AlpenglowIndustries/Alpenglow-Swift/Swift Clamps/SwiftClamps.png

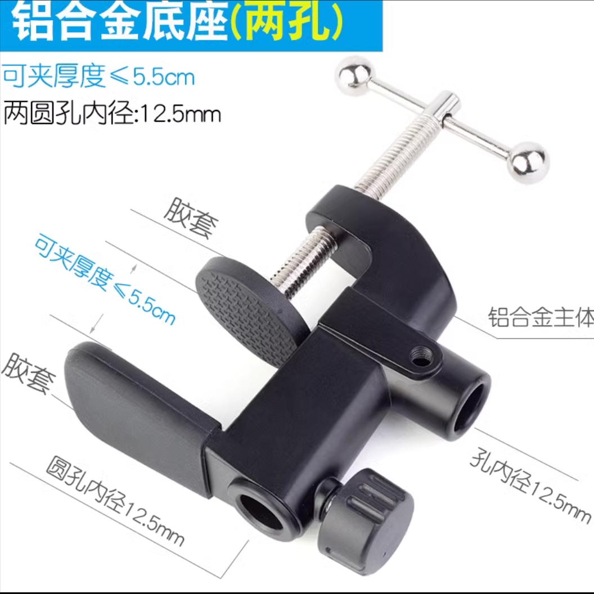
Swift Clamps/SwiftClamps.png
