AlpenglowIndustries/Alpenglow-Swift/Swift Struts/StrutShippingBoxConfig.png

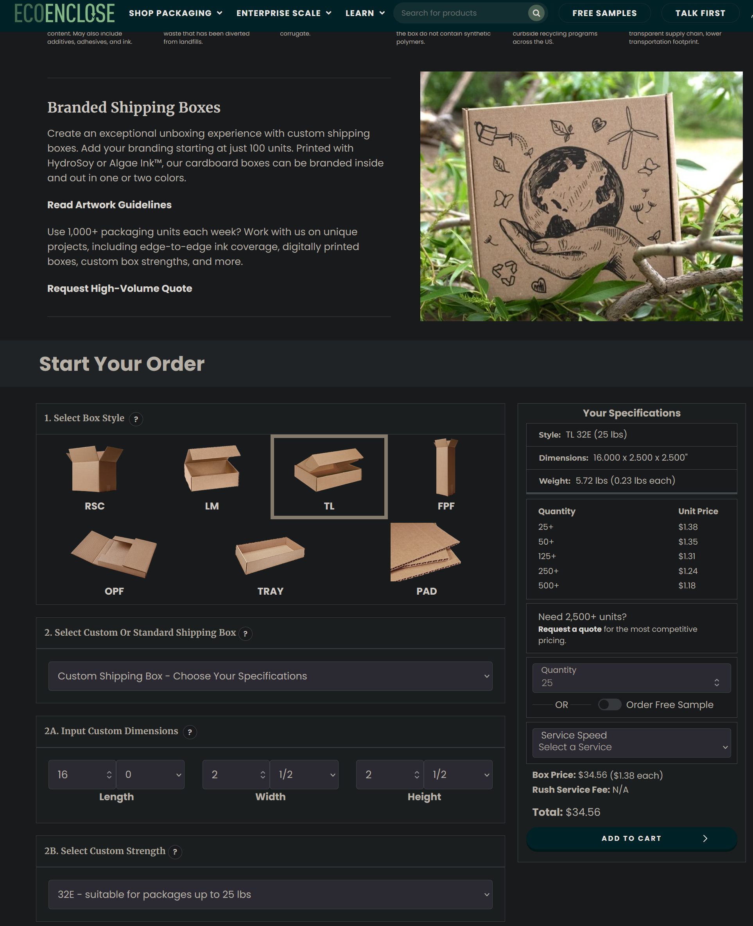
Swift Struts/StrutShippingBoxConfig.png
