AlpenglowIndustries/Alpenglow-Swift/Swift Misc/Strut Ties BUB-66-1.pdf

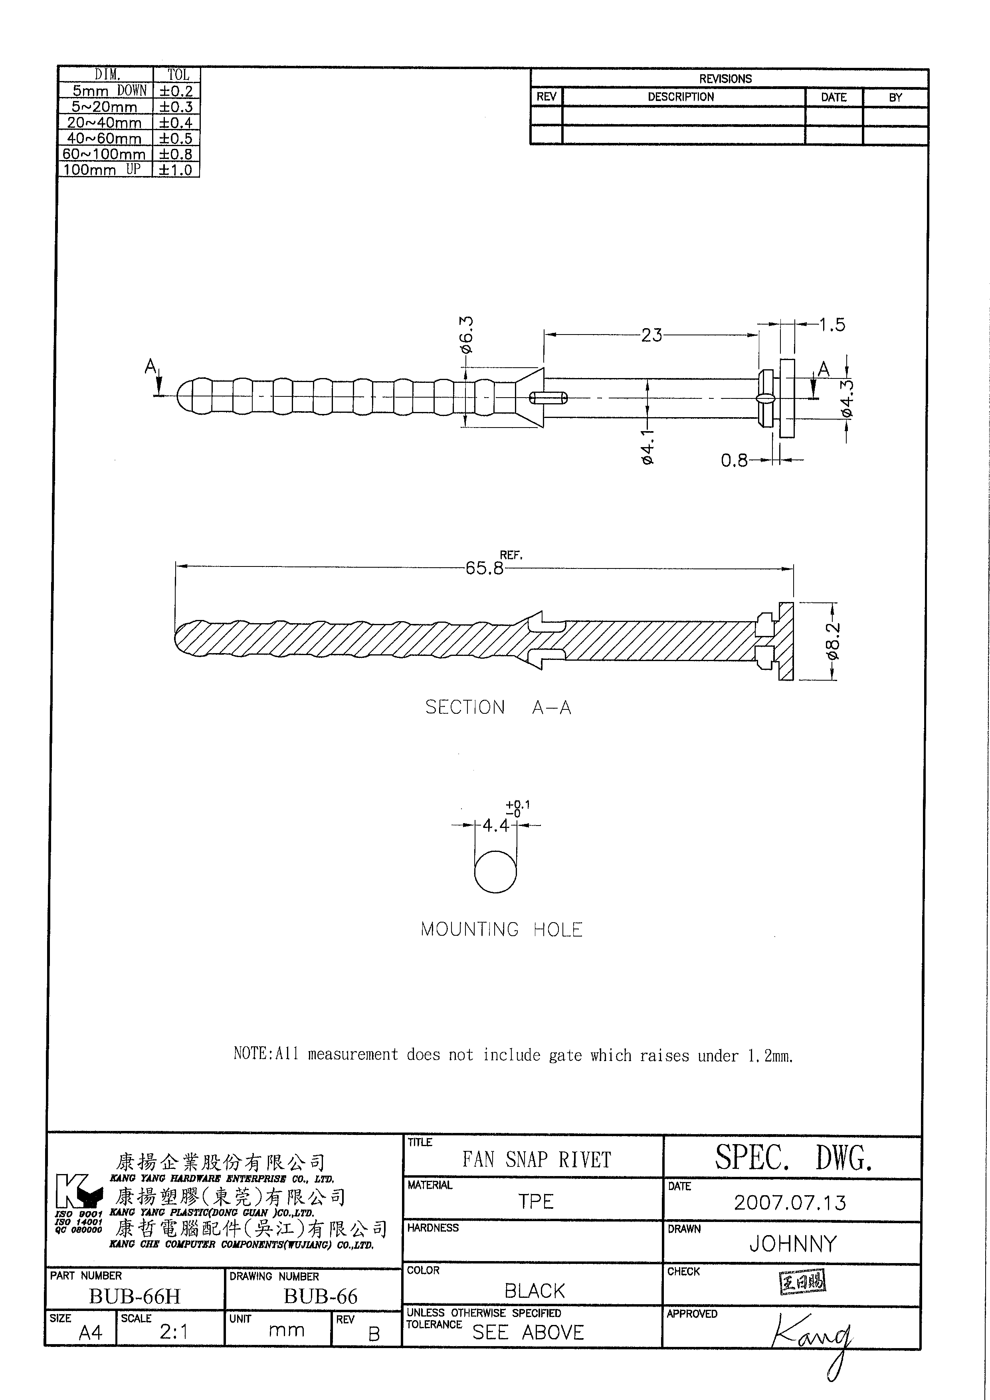
[picture p3: page 1]
