AlpenglowIndustries/Alpenglow-Swift/AlpenglowSwiftBOM.xlsx

Sheet: Swift BOM
Line |  | Type | Qty | Description | Manufacturer | Man Part No | Supplier | Supplier Part No | Supplier Link | Other Notes
1 | WHT | HDWE-CLAMP | 1 | Clamp | Alpenglow |  | Dongguan Oukai Electronics Co Ltd |  | https://pdok.en.alibaba.com/index.html | contact: Kathy Huang
2 | BLK | HDWE-CLAMP | 1 | Clamp | Alpenglow |  | Dongguan Oukai Electronics Co Ltd |  | https://pdok.en.alibaba.com/index.html | contact: Kathy Huang
3 | WHT | HDWE-RINGS | 12 | Fan mount, silicone, long-nose, white, custom ordered | Kang Yang | KYI-BUB-66G(W) | Kang Yang | KYI-BUB-66G(W) | https://www.kangyang-usa.com/product/bub-66/
4 | BLK | HDWE-RINGS | 12 | Fan mount, silicone, long-nose, black | Kang Yang | KYI-BUB-66G | DigiKey | KYI-BUB-66G | https://www.digikey.com/en/products/detail/kang-yang-international/KYI-BUB-66G/13178709
5 | WHT | HDWE-POSTS | 6 | White snap rivet, retainer | Essentra Components | 27MRF09 | DigiKey | RPC7056-ND | available either at Digi-Key or direct from Essentra | "Small Hole" version
6 | WHT | HDWE-POSTS | 6 | White snap rivet, barbed post | Essentra Components | 27MRM090312 | DigiKey | RPC7041-ND | available either at Digi-Key or direct from Essentra | "Small Hole" version
7 | BLK | HDWE-POSTS | 6 | Black snap rivet, retainer | Essentra Components | 27MRF09B | DigiKey | RPC7055-ND | available either at Digi-Key or direct from Essentra | "Small Hole" version
8 | BLK | HDWE-POSTS | 6 | Black snap rivet, barbed post | Essentra Components | 27MRM090312B | DigiKey | RPC7040-ND | available either at Digi-Key or direct from Essentra | "Small Hole" version
9 | WHT | HDWE-WASHER | 2 | 0.74" OD x 0.34" ID x 0.062" thick nylon washer for 5/16" screw size, white | McMaster-Carr | 90295A460 | McMaster-Carr | 90295A460 | www.mcmaster.com
10 | BLK | HDWE-WASHER | 2 | 0.74" OD x 0.34" ID x 0.062" thick nylon washer for 5/16" screw size, black | McMaster-Carr | 90295A460 | McMaster-Carr | 90295A460 | www.mcmaster.com
11 | WHT | PART-FINIAL | 1 | dual color petg finial printed, white. White and Purple PETG is Bambu brand. | Alpenglow |  | Alpenglow |  |  | we printed these in-house because of the dual color
12 | BLK | PART-FINIAL | 1 | dual color petg finial printed, black. Black and Purple PETG is Bambu brand. | Alpenglow |  | Alpenglow |  |  | we printed these in-house because of the dual color
13 | WHT | PART-HUB | 1 | Top Top, white, ABS | Alpenglow |  | Corvallis3D |  | https://corvallis3d.com/
14 | BLK | PART-HUB | 1 | Top Top, black, ABS | Alpenglow |  | Corvallis3D |  | https://corvallis3d.com/
15 | WHT | PART-HUB | 1 | Top Bottom Assy, white, ABS | Alpenglow |  | Corvallis3D |  | https://corvallis3d.com/
16 | BLK | PART-HUB | 1 | Top Bottom Assy, black, ABS | Alpenglow |  | Corvallis3D |  | https://corvallis3d.com/
17 | WHT | PART-HUB | 1 | Bot Top, white, ABS | Alpenglow |  | Corvallis3D |  | https://corvallis3d.com/
18 | BLK | PART-HUB | 1 | Bot Top, black, ABS | Alpenglow |  | Corvallis3D |  | https://corvallis3d.com/
19 | WHT | PART-HUB | 1 | Bot Bottom Assy, white, ABS | Alpenglow |  | Corvallis3D |  | https://corvallis3d.com/
20 | BLK | PART-HUB | 1 | Bot Bottom Assy, black, ABS | Alpenglow |  | Corvallis3D |  | https://corvallis3d.com/
21 | WHT | PART-HUB | 1 | Raising Collar white, ABS | Alpenglow |  | Corvallis3D |  | https://corvallis3d.com/
22 | BLK | PART-HUB | 1 | Raising Collar, black, ABS | Alpenglow |  | Corvallis3D |  | https://corvallis3d.com/
23 | BOTH | PART-HUB | 1 | Linear slide bearing, MJF printed, grey | Alpenglow |  | Streamline3D |  | https://www.streamline-3d.com/
24 | BOTH | HDWE-RINGS | 2 | 6.3" long / 2" diameter, 2.0mm uncoated stainless steel cable screw-lock key rings | Millenial Essentials |  | Amazon | B07R9M5RXT | https://www.amazon.com/dp/B07B93BP3R | alternate: https://www.amazon.com/dp/B088WP8TZB
25 | BOTH | HDWE-RINGS | 1 | 21mm external retaining ring, single turn spiral, stainless | Smalley | VSM-21 | Smalley | VSM-21 | https://www.smalley.com/ring/vsm-21
26 | BOTH | HDWE-SCREW | 6 | #6 flat-head phillips thread-forming screws for brittle plastic, 1/2"L | McMaster-Carr | 96068A153 | McMaster-Carr | 96068A153 | www.mcmaster.com
27 | BOTH | HDWE-SCREW | 1 | #6 Rounded Head Blunt Screws for Sheet Metal, 18-8 Stainless Steel, Number 6 Size, 3/16" Long | McMaster-Carr | 92525A308 | McMaster-Carr | 92525A308 | www.mcmaster.com
28 | BOTH | HDWE-SHAFT COLLAR | 1 | 12mm ID x 30mm OD x 10mm thick dual split shaft collar with screws | QX Hardware Factory Store | SSH12-30-10(2PCS) | AliExpress | 3256805261735830 | https://www.aliexpress.us/item/3256805261735836.html
29 | BOTH | HDWE-SPRING | 1 | 0.25" OD, 0,198" ID, 0.75" long, 0.026" wire dia, 7.82 lbs/in compression spring, 302 stainless | WB Jones | 4037 | WB Jones | 4037 | https://www.springsfast.com/products/compression-springs/part-detail-compression-spring/?part=4037
30 | BOTH | PART-HUB | 1 | Clip Plate, 6061-T6 aluminum 0.06" thick, tumbled finish | Alpenglow |  | Ponoko |  | https://www.ponoko.com/
31 | BOTH | PART-SHAFT | 1 | 6061-T6 AL rod, 19" long, 5/16" threaded one end, plain other end | Alpenglow |  | Elco Machine Co. |  | https://www.elco-machine.com/
32 | BOTH | PART-STRUT | 24 | Acrylic, 3mm thick, 14.25"L x 0.75"W struts | Alpenglow |  | See Acrylic Color Guide sheet |  |  | See Acrylic Color Guide sheet
33 | BOTH | SHIPPING | 1 | 4.5 x 4.5 x 24 inch shipping box, double-wall cardboard, custom made | Alpenglow |  | Albany Box Company |  | https://albanyboxcompany.com/
34 | BOTH | SHIPPING | 1 | Canvas tote bag, Alpenglow branded | Alpenglow |  | Dongguan Dirk Bags Co., Ltd. |  | https://dekehandbag.en.alibaba.com/contactinfo.html | contact: Peter Qiu, dirkbags@163.com
35 | BOTH | SHIPPING | 1 | Instructions card | Alpenglow |  | ASAP Reprographics |  | https://asapreprographics.com/
 |  | Alternates:
9 |  | HDWE-WASHER | 0.028 | 0.032" thick delrin sheet, white | Alpenglow |  | McMaster-Carr | 8573K281 | www.mcmaster.com
10 |  | HDWE-WASHER | 0.028 | 0.032" thick delrin sheet, black | Alpenglow |  | McMaster-Carr | 8575K131 | www.mcmaster.com
5, 6, 7, 8 |  | HDWE-POSTS | 6 | Sets of plastic binding posts and screws, push/snap-in style, 1/4" L, black or white | McMaster-Carr | 90249A610 | McMaster-Carr | 90249A610 | www.mcmaster.com | "Big Hole" version
5, 6, 7, 8 |  | HDWE-POSTS | 6 | Sets of plastic binding posts and screws, push/snap-in style, 1/4" L, white | PopCo | SPLU-250SET/W | PopCo | SPLU-250SET/W | https://www.popco-usa.com/p/white-push-lock-screws-small-head/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 | "Big Hole" version
5, 6, 7, 8 |  | HDWE-POSTS | 6 | Sets of plastic binding posts and screws, push/snap-in style, 1/4" L, black | PopCo | SPLU-250SET/B | PopCo | SPLU-250SET/W | https://www.popco-usa.com/p/black-push-lock-screws-small-head/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 | "Big Hole" version

Sheet: Acrylic Color Guide
Alpenglow Names | Delvies Plastic | Xintao | BuyPlastic | CMB | Contact Info: |  | Notes:
Dazzle Black Gold |  | F1006 |  |  | Delvies Plastic: | https://delviesplastics.com/ | Email Kevin to order full sheets cut to custom size that will fit in your laser - kevin@delviesplastics.com or sales@delviesplastics.com
Dazzle Black Hole | Black Glitter | FHY | MT-14 Black ??? |  | BuyPlastic.com: | https://buyplastic.com/ | ??? means they just started selling glitter, have not ordered from them, am guessing these are compatible colors
Dazzle Black Rainbow |  | F04 |  |  | CMB: | https://www.custommadebetter.com/ | Expensive, not a wholesale, only order here if desperate, they have almost every color we offered
Dazzle Black Slate |  | F1002 |  |  | Xintao: | Mrs Rachel Lee | Min order from Xintao was 10 sheets per color, sheet size: 1020 x 605 x 3mm
Dazzle Blue |  | F5524 (1st order F705) |  |  |  | Account Manager | Orders were paid through Alibaba, comms were via normal email.
Dazzle Cyan |  | F714 (1st order F705) | MT-10 Blue ??? |  |  | Xintao International Group
Dazzle Gold | Gold Glitter |  |  |  |  | Phone: +86 13590605540
Dazzle Green | Ivy Green Glitter |  | MT-09 Green ??? |  |  | Email: rachel@xintaogroup.com
Dazzle Lilac | Lavender Glitter |  |  |  |  | Skype:+86 13590605540
Dazzle Lime |  | F617 1/128 |  |  |  | Wesite: www.xintaogroup.cn
Dazzle Orange |  | F402 1/128 |  |  |  | WA:+86 13590605540
Dazzle Pink |  | F907 1/64 |  |  | Freight: | Honza International Logistics | I had to arrange for sea freight thru Alibaba Logistics and pay that separately.
Dazzle Purple |  | F801 1/64 | MT-07 Violet ??? |  |  | Cindy Zhang | All shipments were packed well and arrived without issues.
Dazzle Rainbow | Confetti Glitter |  |  |  |  | all contact via Alibaba messaging
Dazzle Red | Scarlet Red Glitter |  | MT-11 Red ??? |  |  | https://www.honzalogistics.com/
Dazzle Teal |  | F702
Dazzle Sparkle Surprise |  | F09
Galaxy Green |  | MH-7
Galaxy Purple |  | XKT-4
Galaxy Witch |  | XK-5
Matte Blue |  |  | L-120 Night Blue
Matte Gold |  |  | L-100 Sunset Yellow
Matte Lime | Soft Lime Green
Matte Orange |  |  | L-113 Tropical Orange | Frosted Tropical Orange
Matte Pink | Soft Fuchsia |  | L-038 Taffeta Pink
Matte Purple | Soft Purple |  | L-160 Night Violet
Matte Red | Soft Red |  | L-110 Cherry Red
Matte Teal | Soft Teal |  | L-078 Reef Blue
Neon Lime | 2154 Green |  | L-111 Green
Neon Orange | 2086 Orange |  | L-032 Orange
Neon Pink | 2084 Crimson Red |  | L-116 Red
Shimmer Blue |  | HX133
Shimmer Gold |  | HX102
Shimmer Lilac |  | HX107
Shimmer Lime |  | HX108
Shimmer Orange |  | HX105 |  | Orange Glitter Jellies
Shimmer Pink |  | HX101
Shimmer Rainbow | Clear Glitter | FC-T-100
Shimmer Red |  | HX106
Shimmer Teal |  | HX104
