AlpenglowIndustries/Alpenglow-Swift/Swift Finial/Swift Finial.step

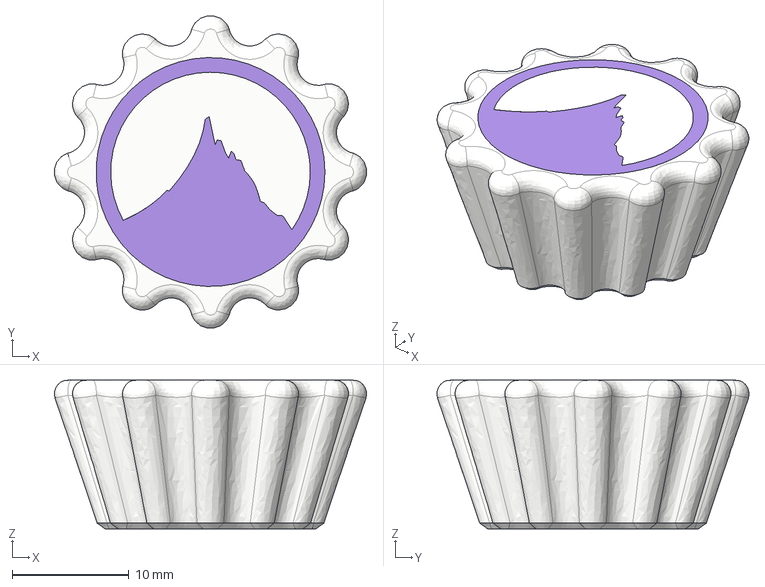
[picture p4: CAD file, 2026-11-03]
Swift Finial/Swift Finial.step
26.7 x 26.7 x 12.7 mm
