AlpenglowIndustries/Alpenglow-Swift/Swift Hubs/Swift Hub Top Top.step

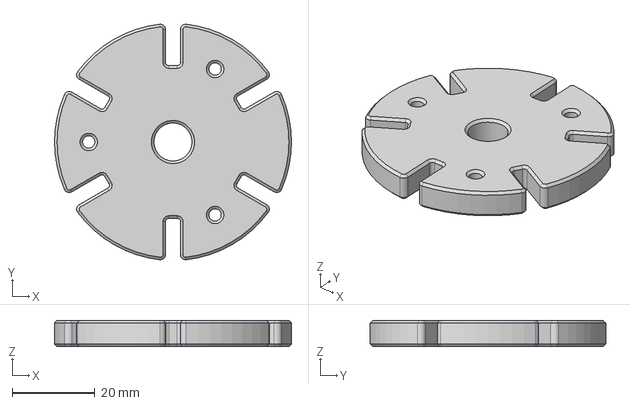
[picture p5: CAD file, 2026-11-03]
Swift Hubs/Swift Hub Top Top.step
57.2 x 56.8 x 6.35 mm
