AlpenglowIndustries/Alpenglow-Swift/Swift Raising Collar Assy/Locking Plate Spacer.step

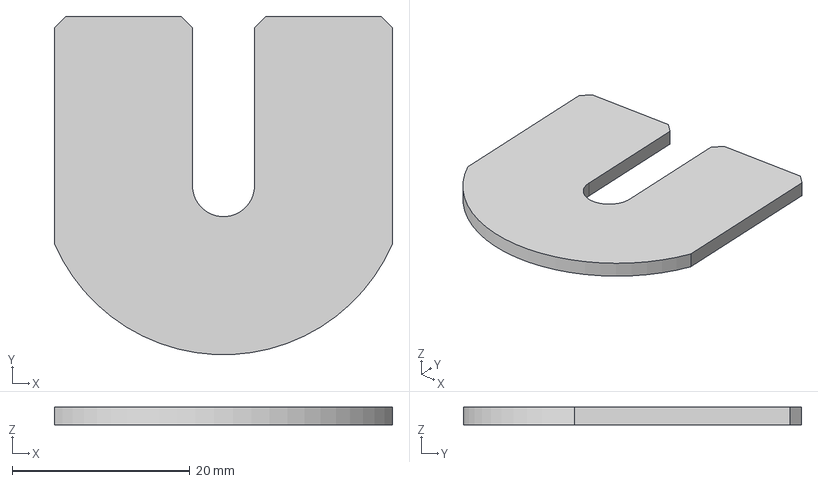
[picture p6: CAD file, 2026-11-03]
Swift Raising Collar Assy/Locking Plate Spacer.step
38.1 x 38.1 x 2.00 mm
