AlpenglowIndustries/Alpenglow-Swift/Swift Shaft/Swift Shaft v20.step

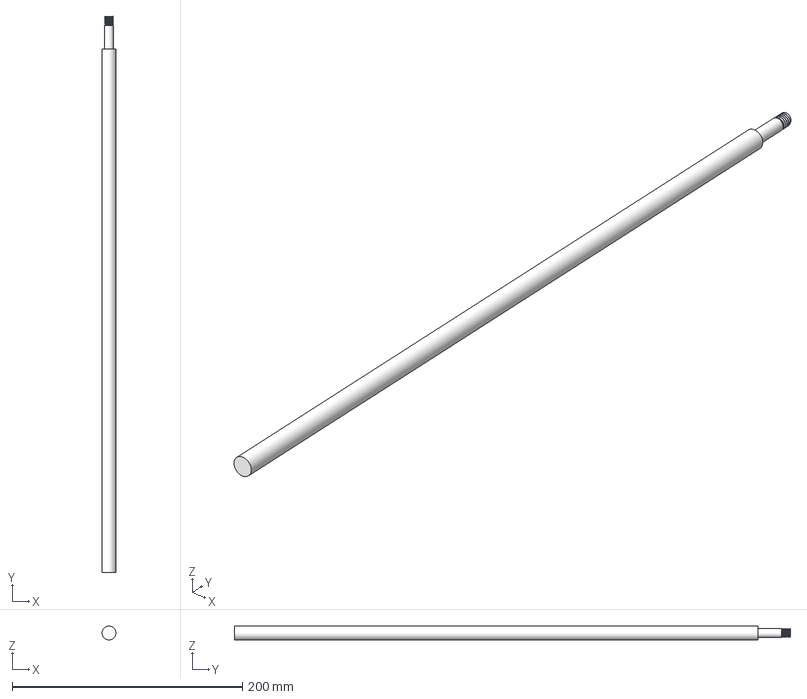
[picture p7: CAD file, 2026-11-03]
Swift Shaft/Swift Shaft v20.step
12.0 x 482.6 x 12.0 mm
