AlpenglowIndustries/Alpenglow-Swift/Swift Struts/Swift Long Strut Big Hole.dxf

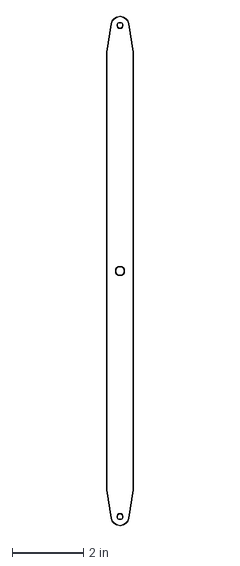
[picture p8: CAD file, 2026-11-03]
Swift Struts/Swift Long Strut Big Hole.dxf
0.75 x 14.3 in
