AlpenglowIndustries/Alpenglow-Swift/Swift Hubs/SwiftHubBotBotV16.stl

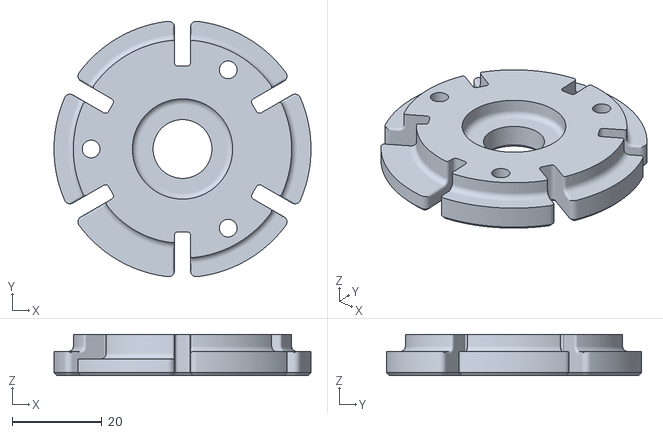
[picture p9: CAD file, 2026-11-03]
Swift Hubs/SwiftHubBotBotV16.stl
57.1 x 56.8 x 9.14
