AlpenglowIndustries/Alpenglow-Swift/Swift Raising Collar Assy/linearbearingv10_x90.stl

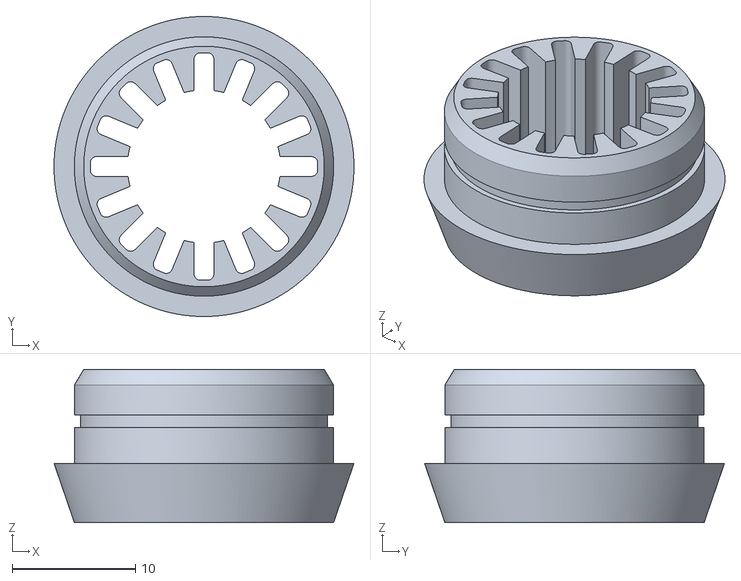
[picture p10: CAD file, 2026-11-03]
Swift Raising Collar Assy/linearbearingv10_x90.stl
24.3 x 24.3 x 12.4
