AlpenglowIndustries/Alpenglow-Swift/Swift Shaft/Swift Shaft.step

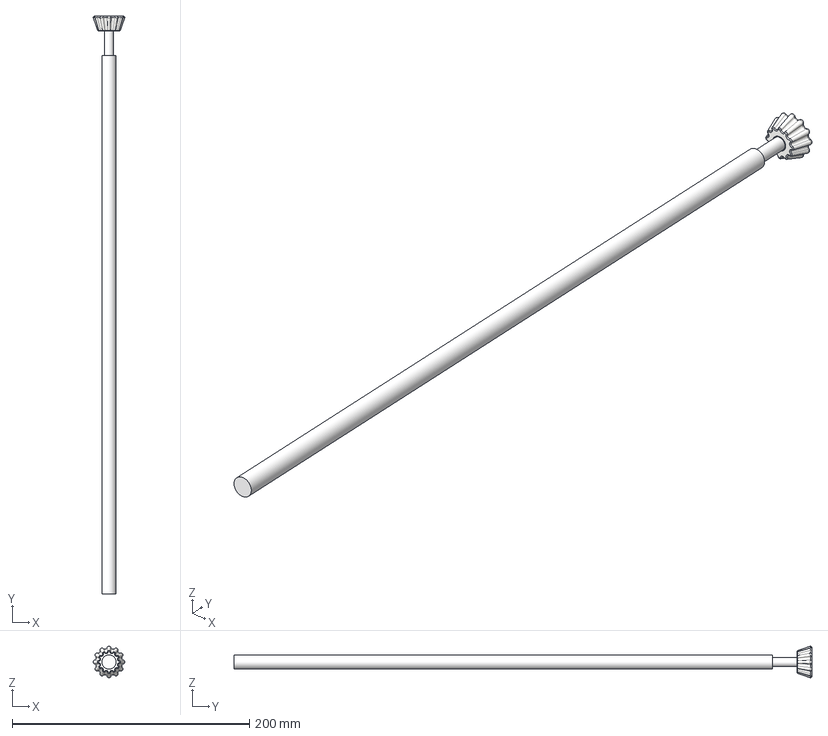
[picture p11: CAD file, 2026-11-03]
Swift Shaft/Swift Shaft.step
26.7 x 487.7 x 26.7 mm
