AlpenglowIndustries/Alpenglow-Swift/Swift Struts/Swift Strut.step

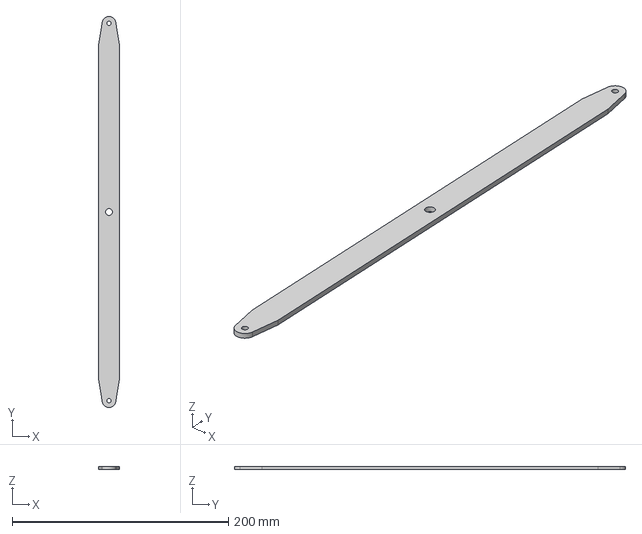
[picture p12: CAD file, 2026-11-03]
Swift Struts/Swift Strut.step
19.0 x 361.9 x 3.17 mm
