AlpenglowIndustries/Alpenglow-Swift/Swift Hubs/SwiftHubParts.3mf

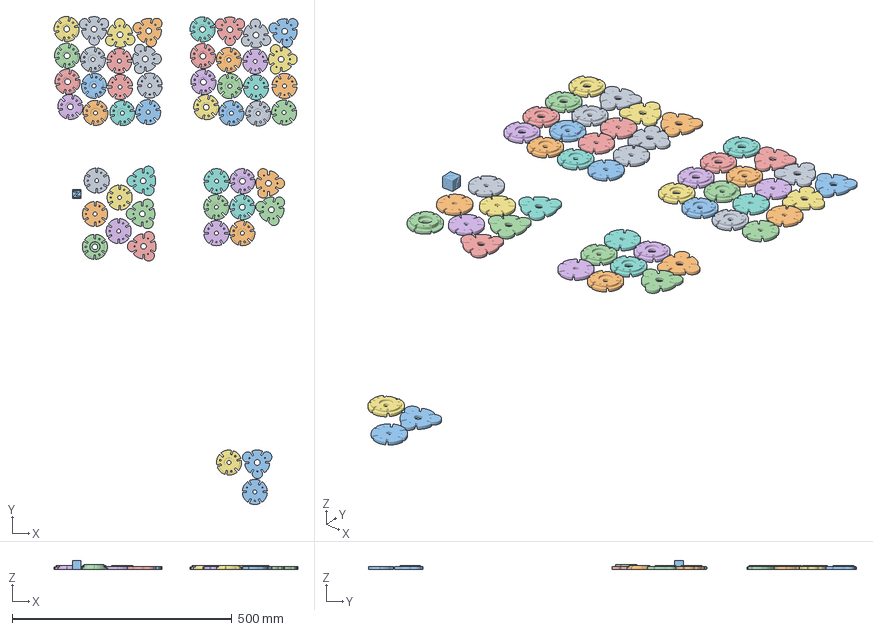
[picture p13: CAD file, 2026-11-03]
Swift Hubs/SwiftHubParts.3mf
554.7 x 1110.3 x 20.0 mm
SwiftHubBotTopV11.stl x 11
SwiftHubTopTopV11.stl x 11
SwiftHubBotBotV16.stl x 10
SwiftHubTopBotV16.stl x 11
Swift Bottom Hub Assy Printed v19.stl
Swift Hub Bot Top for Printing v9.stl x 3
Swift Hub Top Top for Printing v6.stl x 4
20mm Calibration Cube XYZ.stl
