AlpenglowIndustries/Alpenglow-Swift/Swift Raising Collar Assy/Locking Plate - Spring Clip Lower Metal v15.dxf

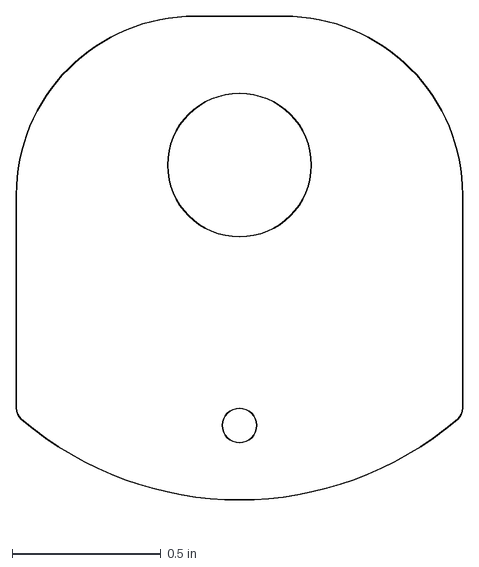
[picture p14: CAD file, 2026-11-03]
Swift Raising Collar Assy/Locking Plate - Spring Clip Lower Metal v15.dxf
1.50 x 1.72 in
