AlpenglowIndustries/Alpenglow-Swift/Swift Hubs/Swift Hub Bot Bot.step

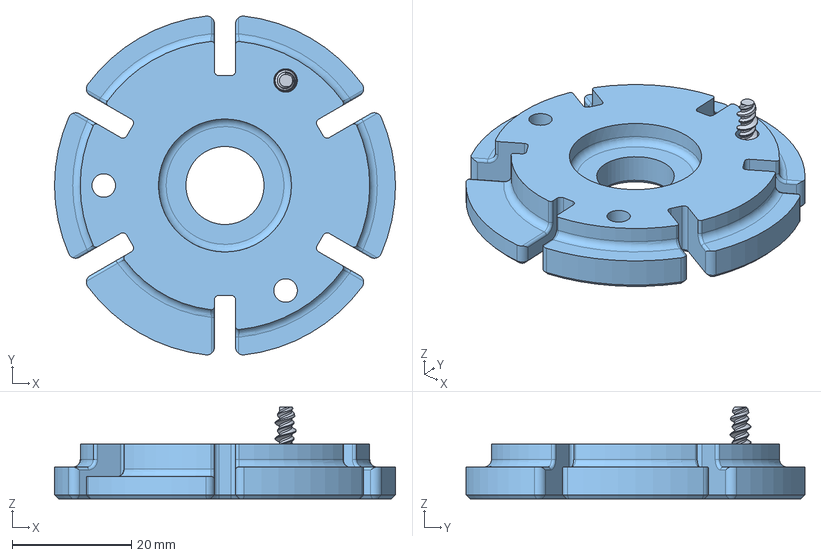
[picture p15: CAD file, 2026-11-03]
Swift Hubs/Swift Hub Bot Bot.step
57.1 x 56.8 x 15.3 mm
