AlpenglowIndustries/Alpenglow-Swift/Swift Hubs/Swift Hub Bot Top.step

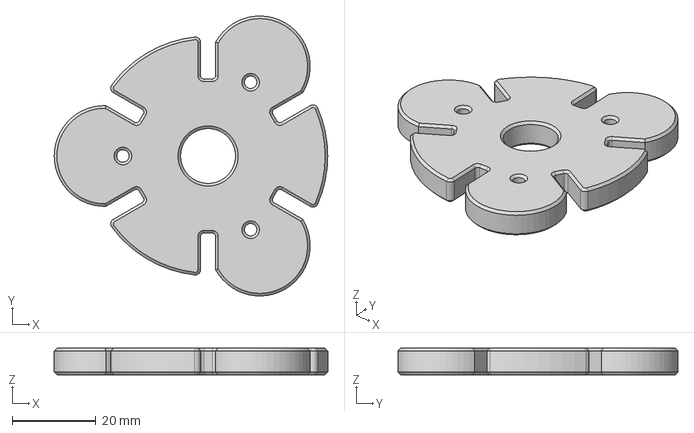
[picture p16: CAD file, 2026-11-03]
Swift Hubs/Swift Hub Bot Top.step
65.3 x 66.8 x 6.35 mm
