AlpenglowIndustries/Alpenglow-Swift/Swift Hubs/Swift Hub Top Bot.step

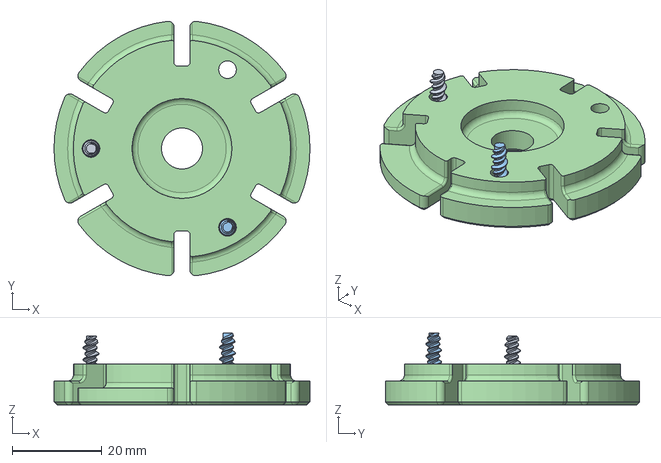
[picture p17: CAD file, 2026-11-03]
Swift Hubs/Swift Hub Top Bot.step
57.1 x 56.8 x 16.0 mm
96068A153_Flat Head Thread-Forming Screws
96068A156_Flat Head Thread-Forming Screws
