AlpenglowIndustries/Alpenglow-Swift/Swift Raising Collar Assy/SwiftHubRaisingCollar.3mf

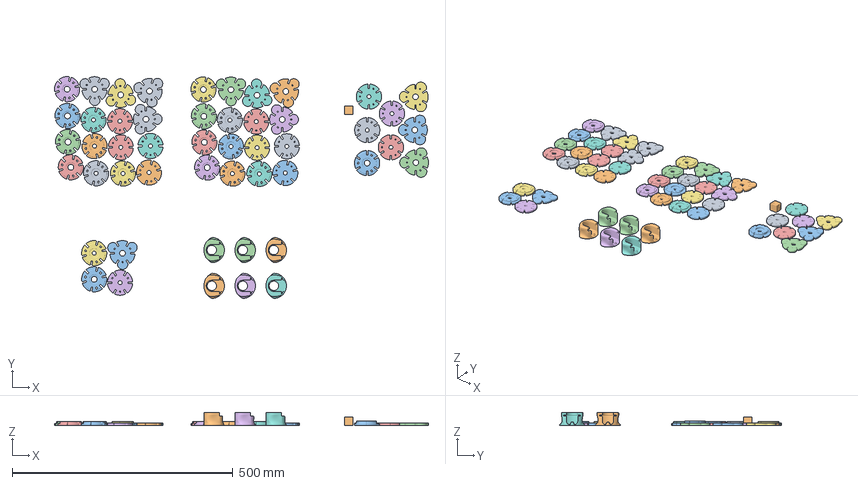
[picture p18: CAD file, 2026-11-03]
Swift Raising Collar Assy/SwiftHubRaisingCollar.3mf
848.1 x 503.0 x 30.5 mm
SwiftHubBotTopV11.stl x 9
RaisingCollar-v10.stl x 6
SwiftHubTopTopV11.stl x 9
SwiftHubTopBotV16.stl x 9
SwiftHubBotBotV16.stl x 9
Swift Bottom Hub Assy Printed v19.stl
Swift Hub Bot Top for Printing v9.stl x 3
Swift Hub Top Top for Printing v6.stl x 4
20mm Calibration Cube XYZ.stl
