AlpenglowIndustries/Alpenglow-Swift/Swift Raising Collar Assy/Locking Plate - Spring Clip Lower Metal.step

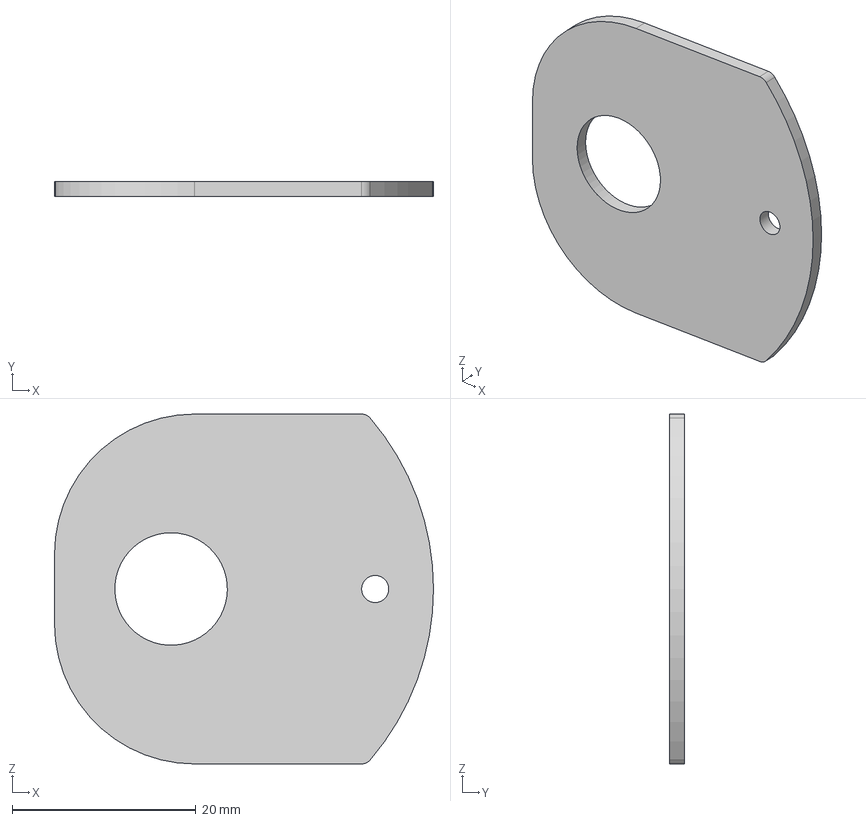
[picture p19: CAD file, 2026-11-03]
Swift Raising Collar Assy/Locking Plate - Spring Clip Lower Metal.step
41.3 x 1.60 x 38.1 mm
