AlpenglowIndustries/Alpenglow-Swift/Swift Raising Collar Assy/Raising Collar.step

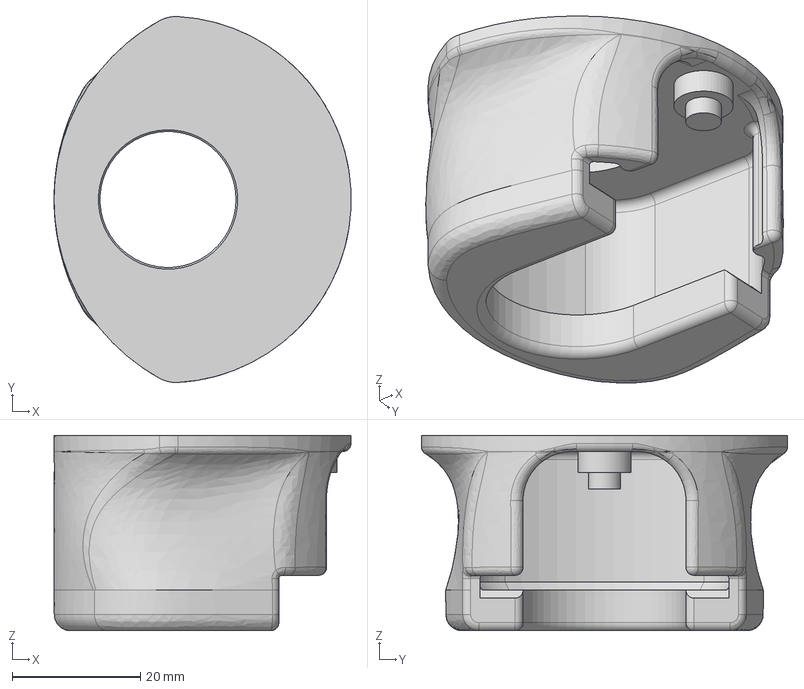
[picture p20: CAD file, 2026-11-03]
Swift Raising Collar Assy/Raising Collar.step
46.3 x 57.1 x 30.5 mm
