AlpenglowIndustries/Alpenglow-Swift/Swift Hubs/SwiftHubTopBotV16.stl

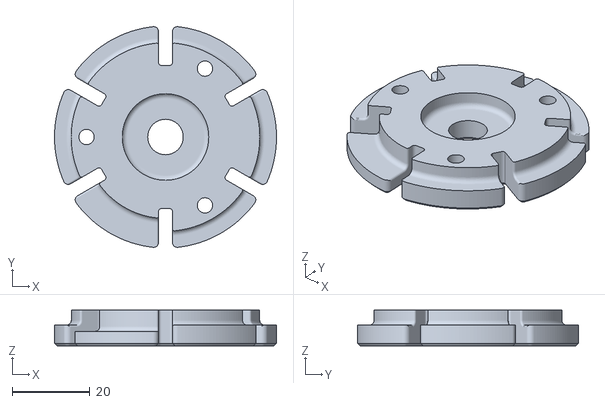
[picture p21: CAD file, 2026-11-03]
Swift Hubs/SwiftHubTopBotV16.stl
57.1 x 56.8 x 9.14
