AlpenglowIndustries/Alpenglow-Swift/(list of files, cad)

Other CAD files:
Swift Finial/Swift Finial v20.3mf
Swift Raising Collar Assy/Linear Bearing.step
Swift Raising Collar Assy/linearbearingv10_x90_repaired.stl
Swift Hubs/SwiftHubTopTopV11.stl
Swift Hubs/SwiftHubBotTopV11.stl
Swift Raising Collar Assy/RaisingCollar-v10.stl
Swift Finial/Swift Finial.f3d
Swift Hubs/Swift Hub Bot Bot.f3d
Swift Hubs/Swift Hub Bot Top.f3z
Swift Hubs/Swift Hub Top Bot.f3d
Swift Hubs/Swift Hub Top Top.f3z
Swift Raising Collar Assy/Linear Bearing.f3z
Swift Raising Collar Assy/LinearBearing.3mf
Swift Raising Collar Assy/Locking Plate - Spring Clip Lower Metal.f3d
Swift Raising Collar Assy/Locking Plate Spacer.dxf
Swift Raising Collar Assy/Locking Plate Spacer.f3d
Swift Raising Collar Assy/Raising Collar.f3d
Swift Shaft/Swift Shaft.f3z
Swift Struts/Swift Strut.f3d
