AlpenglowIndustries/Alpenglow-Swift/The Glider Swift User Guide For Web.pdf

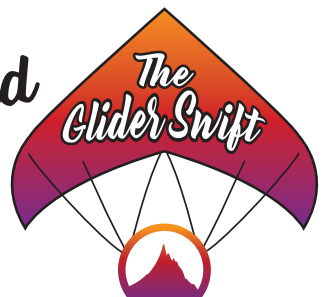
[picture p22: figure]

# Time to relax and

unwind with...

Welcome to a new smooth unwinding experience! The Glider Swift operates a little differently from traditional wood umbrella-style swifts, we recommend raising and lowering it a few times without yarn, just to get the feel of it. Before you start, make sure your swift is firmly clamped to a sturdy table.

### Raising / Expanding the Swift:

Grasp the “Raising Collar” on its indented sides above the metal plate. Gently push up. That’s it! The metal plate is a cantilever style that automatically locks the shell in place.

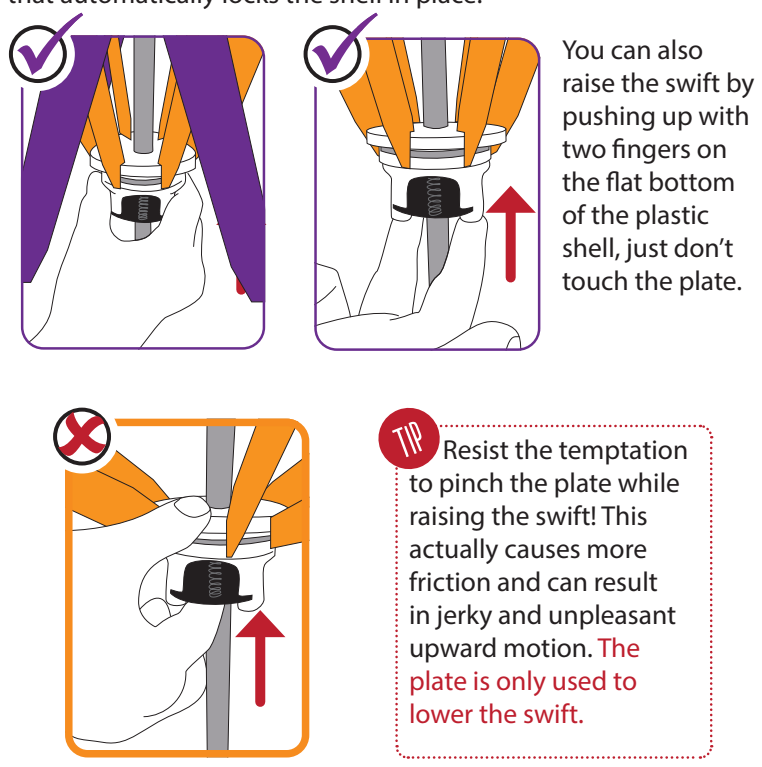
[picture p23: figure]
Resist the temptation to pinch the plate while raising the swift! This actually causes more friction and can result in jerky and unpleasant upward motion. The plate is only used to lower the swift.; TIP; You can also raise the swift by pushing up with two fingers on the flat bottom of the plastic shell, just don’t touch the plate.

### Lowering / Collapsing the Swift:

Lift the “Lowering Plate”. You can do this by ever-so-gently pinching the entire bottom hub and shell – we find that it’s easiest to pinch between our thumb and first knuckle, but do whatever is most comfortable for you.

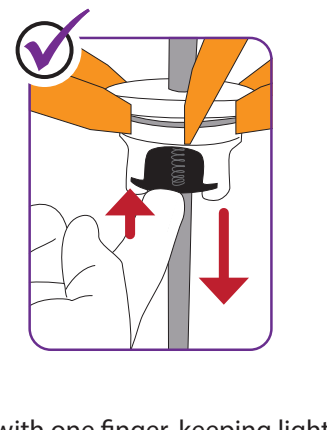
[picture p24: figure]
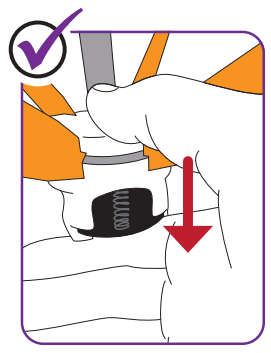
[picture p25: figure]

You can also tip the plate upward with one finger, keeping light upward pressure on it as you move the entire collar downward.

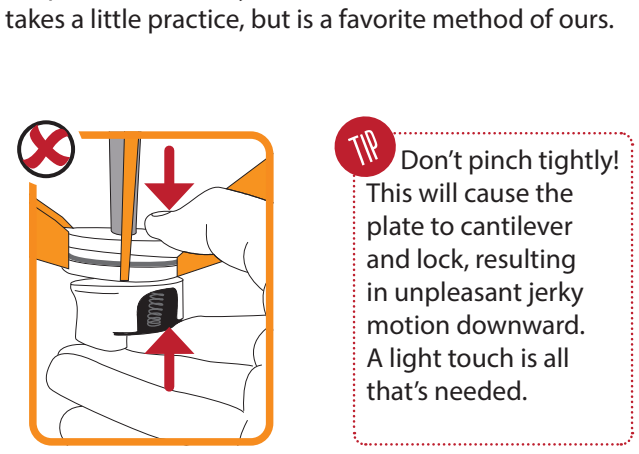
[picture p26: figure]
Don’t pinch tightly! This will cause the plate to cantilever and lock, resulting in unpleasant jerky motion downward. A light touch is all that’s needed.; TIP

This takes a little practice, but is a favorite method of ours.

### Placing Yarn on the Swift:

We like to slightly raise the swift, place the yarn around it, then finish raising it with the other hand. Only raise the swift until the yarn is lightly snug around it. You don’t need a lot of tension, and too much tension can actually cause the yarn to snag more while unwinding.

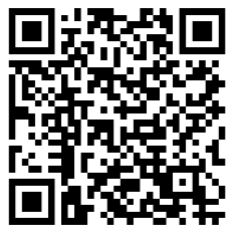
[picture p27: figure]

If the skein is a little sloppy on the swift, take it off, snap the skein a few times and put it back on the swift. Check out our videos and online guide for very useful unwinding tips that we guarantee will save you curses and tears, if not hours of tangled woe!

## TIP

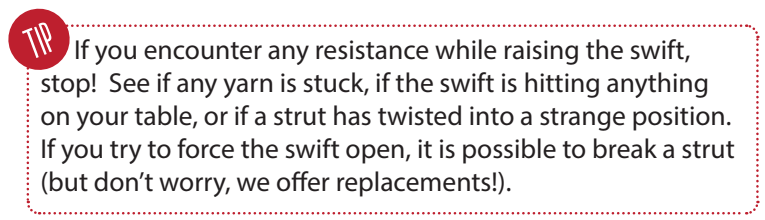
[picture p28: figure]
TIP

If you encounter any resistance while raising the swift, stop! See if any yarn is stuck, if the swift is hitting anything on your table, or if a strut has twisted into a strange position. If you try to force the swift open, it is possible to break a strut (but don’t worry, we offer replacements!).

### LOOSE

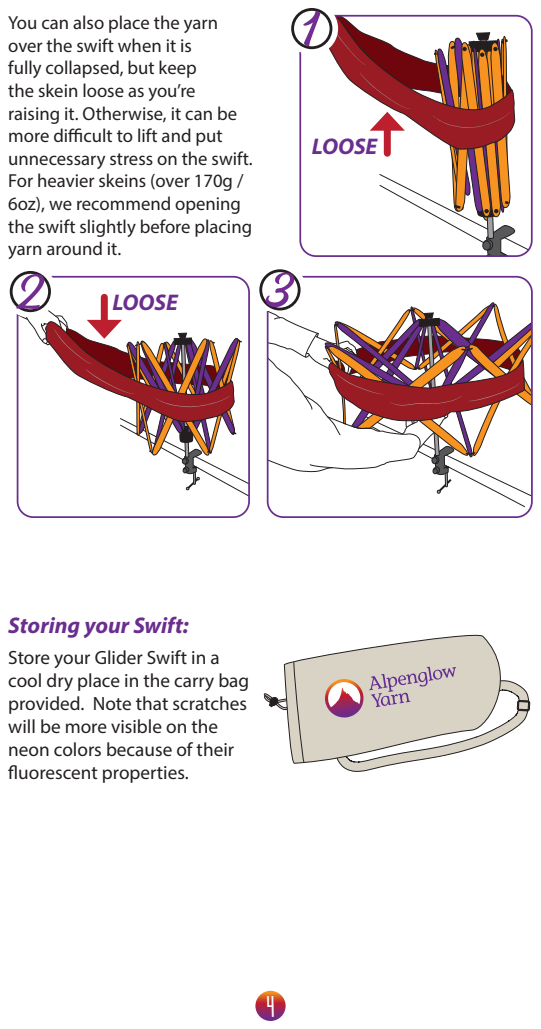
[picture p29: page 4]
LOOSE

You can also place the yarn
over the swift when it is
fully collapsed, but keep
the skein loose as you’re
raising it. Otherwise, it can be
more difficult to lift and put
unnecessary stress on the swift.
For heavier skeins (over 170g /
6oz), we recommend opening
the swift slightly before placing
yarn around it.

Storing your Swift:
Store your Glider Swift in a
cool dry place in the carry bag
provided. Note that scratches
will be more visible on the
neon colors because of their
fluorescent properties.

### Using the Swift Horizontally:

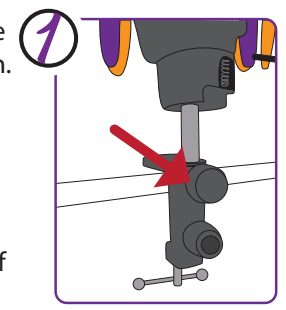
[picture p30: figure]

The two-way clamps also allow you to use the Glider Swift in a horizontal orientation. Which way to use it is just personal preference. To change it from the vertical orientation, first fully collapse the swift. Loosen the knob holding the shaft in the vertical shaft hole. Grasping around the struts, pull the swift straight up and out of

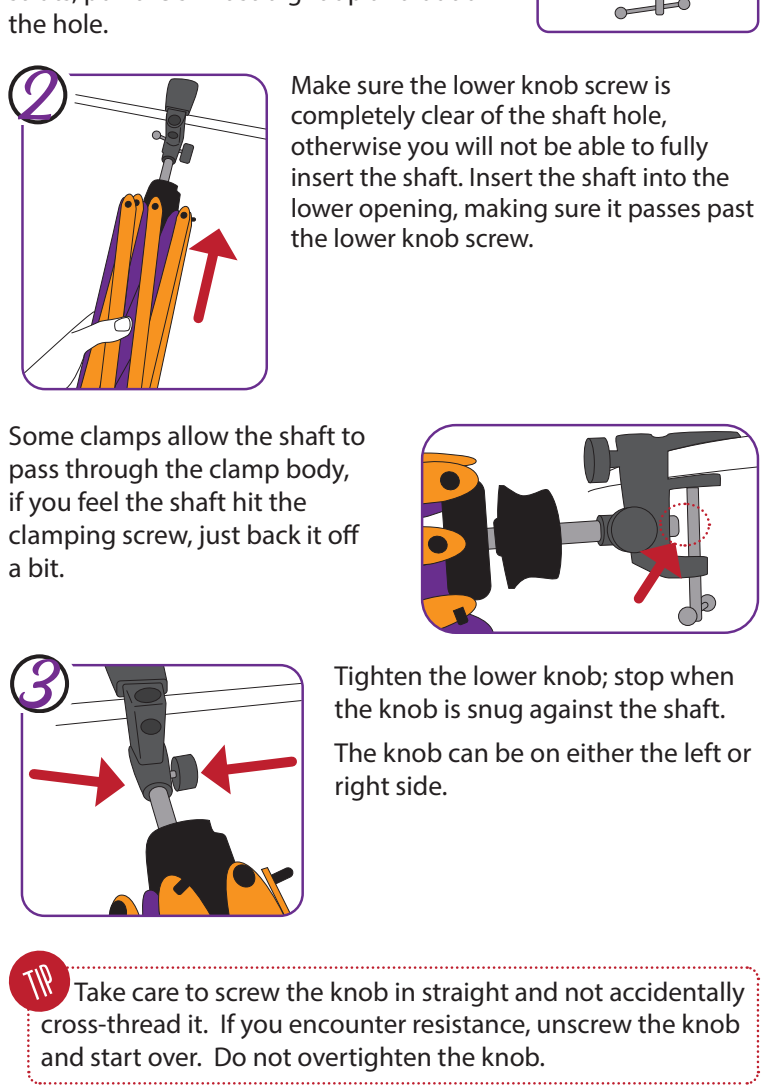
[picture p31: figure]
Tighten the lower knob; stop when the knob is snug against the shaft. The knob can be on either the left or right side.; the hole.; Make sure the lower knob screw is completely clear of the shaft hole, otherwise you will not be able to fully; the lower knob screw.; Some clamps allow the shaft to pass through the clamp body, if you feel the shaft hit the clamping screw, just back it off a bit.; TIP

insert the shaft. Insert the shaft into the lower opening, making sure it passes past

Take care to screw the knob in straight and not accidentally cross-thread it. If you encounter resistance, unscrew the knob and start over. Do not overtighten the knob.

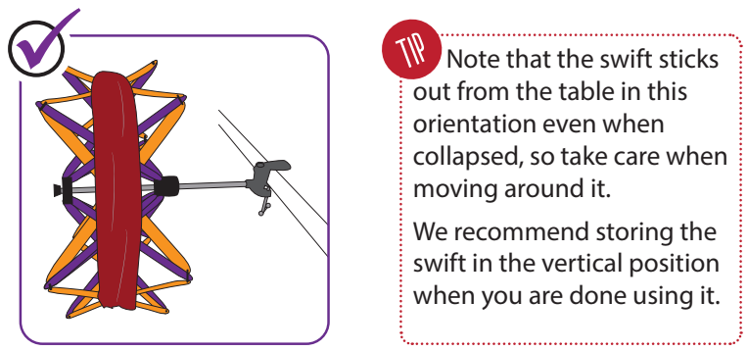
[picture p32: figure]
Note that the swift sticks out from the table in this orientation even when collapsed, so take care when moving around it. We recommend storing the swift in the vertical position when you are done using it.; TIP

Do you love your new swift? Let us know! We love to be tagged and want to see your swift in all its glittery or seaglassy glory.

Be sure to follow us and sign up for our newsletter to
get updates on new gizmos, and tips and tricks for
successful yarn wrangling.
If you have any issues or questions, check out the
Support section of our website! You can reach us via our website’s Contact form, or email us at info@alpenglowyarn.com. We want you to be stoked with your new swift!

### alpenglowyarn.com

@alpenglowyarn, #gliderswift

To change it back to vertical, first fully collapse the swift. Reverse the process, loosening the bottom knob and pulling the swift out of the hole. Be sure the top knob screw is clear of the shaft hole and that the shaft passes beyond the screw. Tighten the top knob screw until snug.

Expanding and collapsing the swift work the same as in the vertical orientation.
