AlpenglowIndustries/Alpenglow-Swift/Swift Raising Collar Assy/RaisingCollar-v10 Drawing.pdf

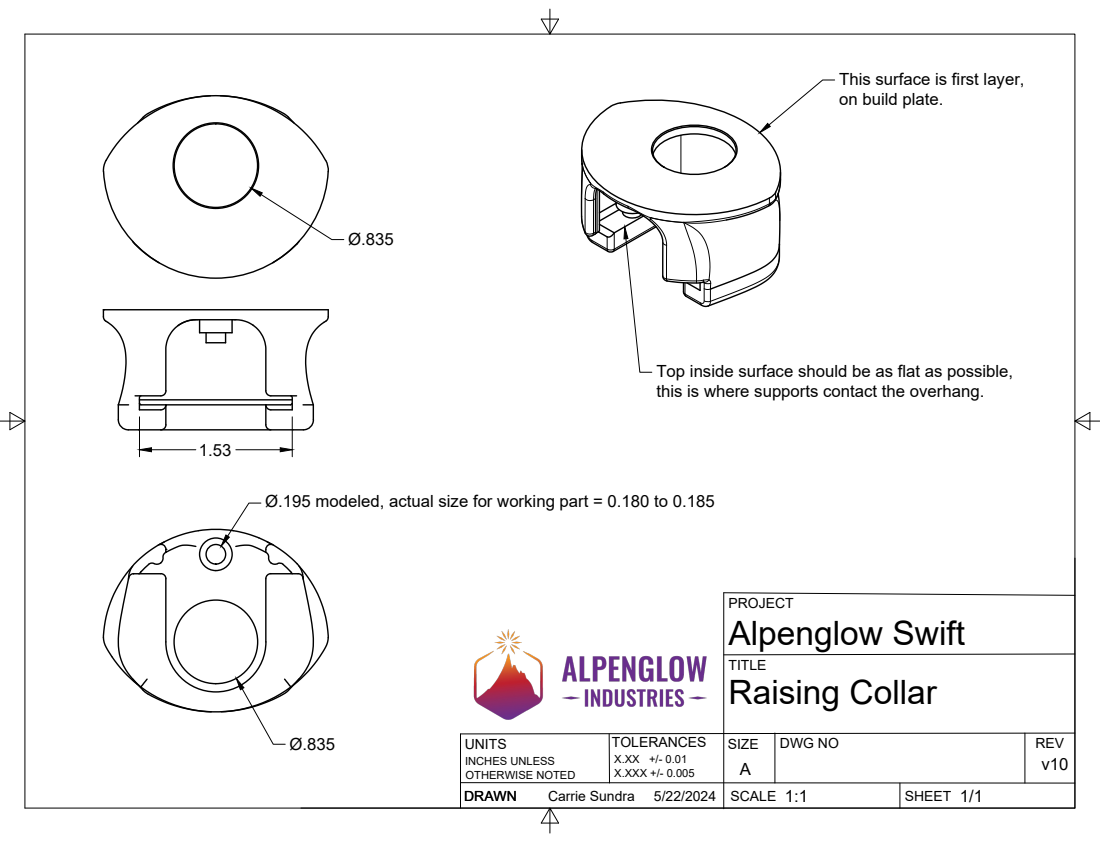
[picture p36: page 1]
SIZE; DWG NO; REV; INCHES UNLESS OTHERWISE NOTED; X.XX +/- 0.01 X.XXX +/- 0.005; Carrie Sundra; Alpenglow Swift; Raising Collar

This surface is first layer,
on build plate.

Top inside surface should be as flat as possible,
this is where supports contact the overhang.

Ø.195 modeled, actual size for working part = 0.180 to 0.185
