AlpenglowIndustries/Alpenglow-Swift/Swift Shaft/Swift Shaft Drawing v20.pdf

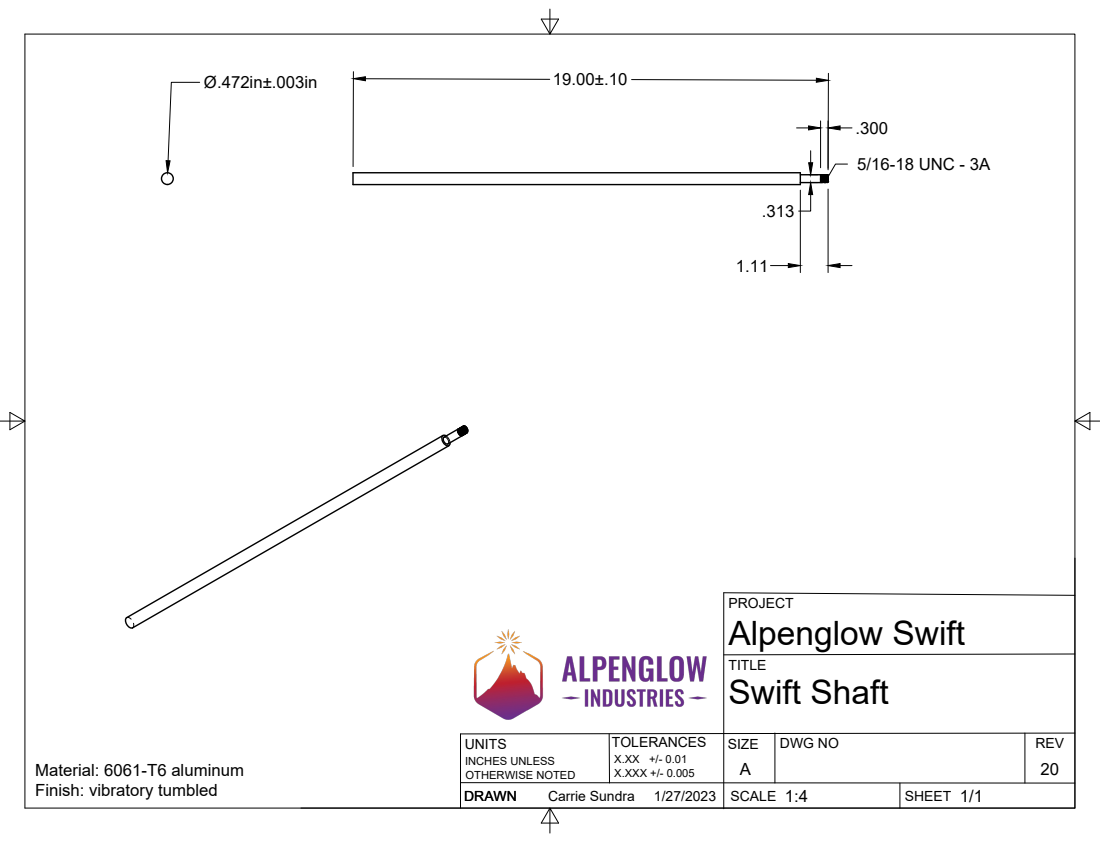
[picture p37: page 1]
5/16-18 UNC - 3A; SIZE; DWG NO; REV; INCHES UNLESS OTHERWISE NOTED; X.XX +/- 0.01 X.XXX +/- 0.005; Carrie Sundra; Alpenglow Swift; Swift Shaft

Material: 6061-T6 aluminum
Finish: vibratory tumbled
