AlpenglowIndustries/Alpenglow-Swift/Swift Hubs/Swift Hub Bot Bot v16 Drawing v2.pdf

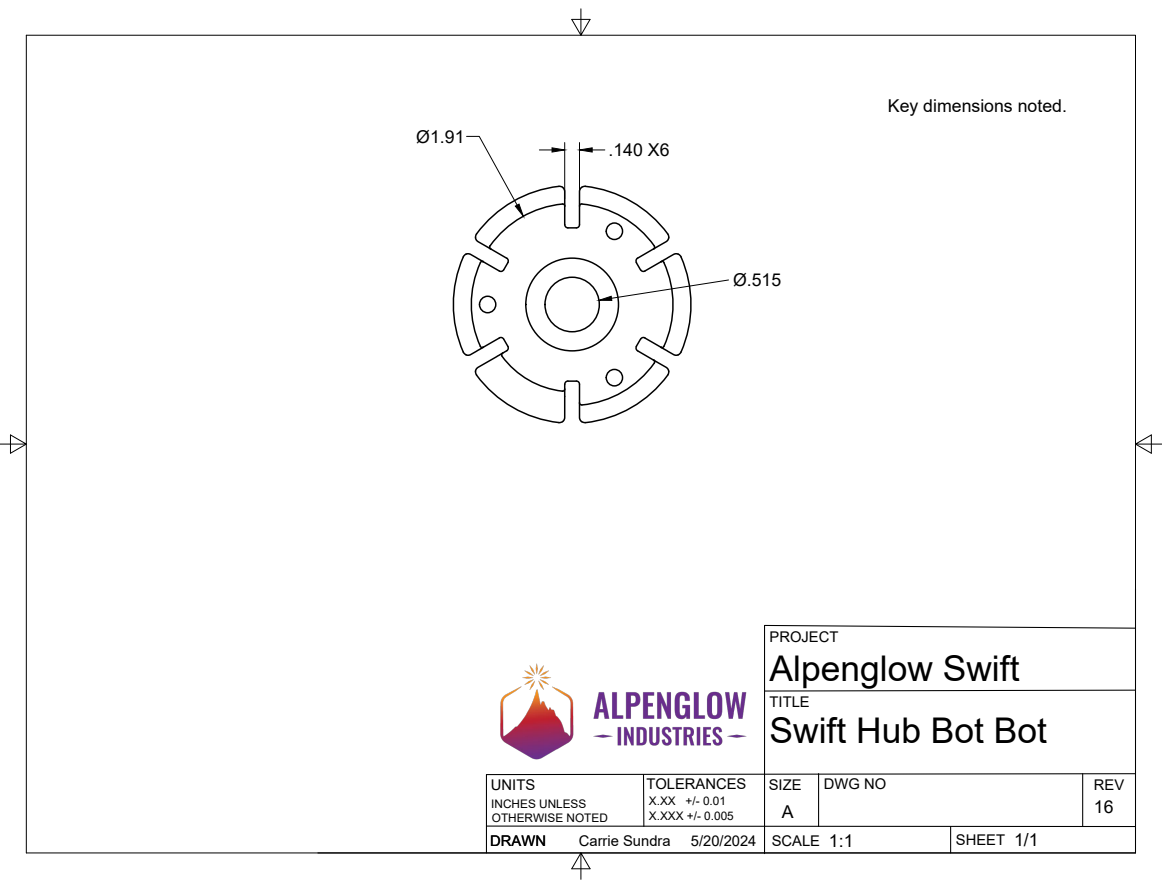
[picture p38: page 1]
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

Key dimensions noted.

PROJECT
Alpenglow Swift
Swift Hub Bot Bot
