AlpenglowIndustries/Alpenglow-Swift/(commit log)

2026-11-03 initial commit of files
    [AlpenglowSwiftBOM.xlsx, Linear Bearing.f3z, Linear Bearing.step, LinearBearing.3mf, Locking Plate - Spring Clip Lower Metal v15.dxf, Locking Plate - Spring Clip Lower Metal.f3d, Locking Plate - Spring Clip Lower Metal.step, Locking Plate Spacer.dxf]
2026-11-05 added bom and color guide files as csv
    [AcrylicColorGuide.csv, AlpenglowSwiftBOM.csv]
2026-11-06 added info for replacement strut shipping boxes
    [Swift Long Strut Big Hole.dxf]
